laurencebarker/Log-VSWR-Bridge/displays/arduino_library_update/readme.md

These 5 files should be coplied to the ITEADLIB_Arduino_Nextion folder in your "documents\arduino" folder. They replace 4 files in the Arduino library.
