laurencebarker/Log-VSWR-Bridge/displays/crossed needle 20.png

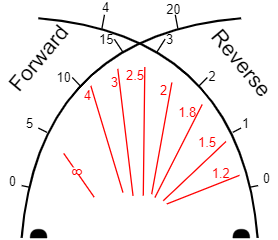
displays/crossed needle 20.png
