laurencebarker/Log-VSWR-Bridge/displays/linear power meter-Analogue Meter 2.png

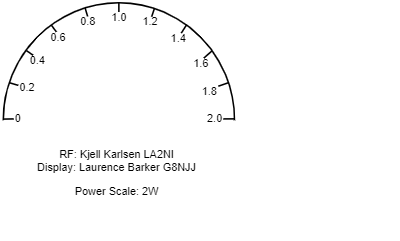
displays/linear power meter-Analogue Meter 2.png
