laurencebarker/Log-VSWR-Bridge/displays/simple bargraph.png

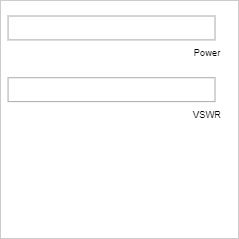
displays/simple bargraph.png
