laurencebarker/Log-VSWR-Bridge/hardware/VSWR bridge BOM.xlsx

VSWR Bridge
Qty | Ref | Part | RS part no.
8 | R1-R4, R9-R12 | 300R size?
4 | R5-R8 | 75R size?
4 | R13, R16, R18, R19 | 560R size?
4 | R14, R17,R31, R32 | 120R
2 | R15, R20 | 27R 0603
2 | R23, R24 | 4R7 0603
2 | R21, R22 | 47K 0603
2 | R29, R30 | wire
2 | R26, R28 | 10K 0603
2 | R25, R27 | 27K 0603
3 | L1, L2, L4 | ferrite bead L 4.5mm W2.1mm
16 | C1, C2, C3, C4, C6, C8, C13, C15-C18, C19, C20, C21, C22, C23 | 100nF 0805
4 | C9-C12 | 47uF +16v tant L=5mm
2 | C5, C7 | 10nF 0805
2 | IC2, IC3 | AD8310
1 | U1 | LMC660
1 | U2 | 78L05
1 | U3 | 78L08
1 | D1 | S1M
2 | J1, J2 | BNC straight
Arduino / Display
Qty | Ref | Part | RS part no.
4 | L2 L3 L4 L6 | Ferrite bead
1 | D3 | 3.3V zener
1 | D2 | BAS16J
2 | D4, D5 | diode SS34
1 | IC1 | Arduino Nano Every
1 | IC3 | TLV1117-5.0
1 | T1 | NX2301P
1 | T2 | 2N7002KL
1 | U1 | LM393
9 | C10, C11, C12, C13, C16, C17, C18, C21, C24 | 100nF 0805
5 | C6, C7,C8,C9,C20 | 10nF 0805
3 | C19, C22, C26 | 1uF 0805
1 | C23 | 4.7uF
2 | C14, C15 | 22uF
2 | C25, C27 | 10uF 0805
2 | R11, R12 | 10K 0603
2 | R8, R9 | 100K 0603
1 | R10 | 180K 0603
1 | R13 | 22K potentiometer
1 | switch | push
1 | case | Hammond 1455N1201
2 | battery | 18650 Li-ion
DNI | C1, C3, C4, C5
DNI | R1 - R7
DNI | L1, L5
DNI | IC2 IC4
DNI | D1
