laurencebarker/Log-VSWR-Bridge/documentation/sensor calibration and lookup table.xlsx

From calibration:
Offset value | -96 | dBm
Scale value | 0.1253 | dBm/step
coupling coefficient | 50 | dB
Zo | 50 | Ω
sensor power dBm = ADC reading*scale + offset |  |  |  |  |  |  |  |  |  |  |  |  | paste 128 cells from column P into Arduino editor
ADC Value | sensor Power dBm | Power W | RMS line volts | start value
0 | -96 | 2.511886432e-08 | 0.001120688724 | 1 | 0.001120688724 | 0.001136972609 | 0.001153493103 | 0.001170253644 | 0.00118725772 | 0.001204508869 | 0.001222010682 | 0.0012397668 | 0.00112,0.00114,0.00115,0.00117,0.00119,0.0012,0.00122,0.00124,
1 | -95.8747 | 2.585413427e-08 | 0.001136972609 | 9 | 0.001257780919 | 0.001276056788 | 0.00129459821 | 0.001313409043 | 0.001332493202 | 0.001351854659 | 0.001371497443 | 0.001391425641 | 0.00126,0.00128,0.00129,0.00131,0.00133,0.00135,0.00137,0.00139,
2 | -95.7494 | 2.661092678e-08 | 0.001153493103 | 17 | 0.001411643401 | 0.001432154929 | 0.001452964496 | 0.00147407643 | 0.001495495127 | 0.001517225042 | 0.001539270698 | 0.001561636683 | 0.00141,0.00143,0.00145,0.00147,0.0015,0.00152,0.00154,0.00156,
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
