laurencebarker/Log-VSWR-Bridge/hardware/LTB Power Meter_Schema.pdf

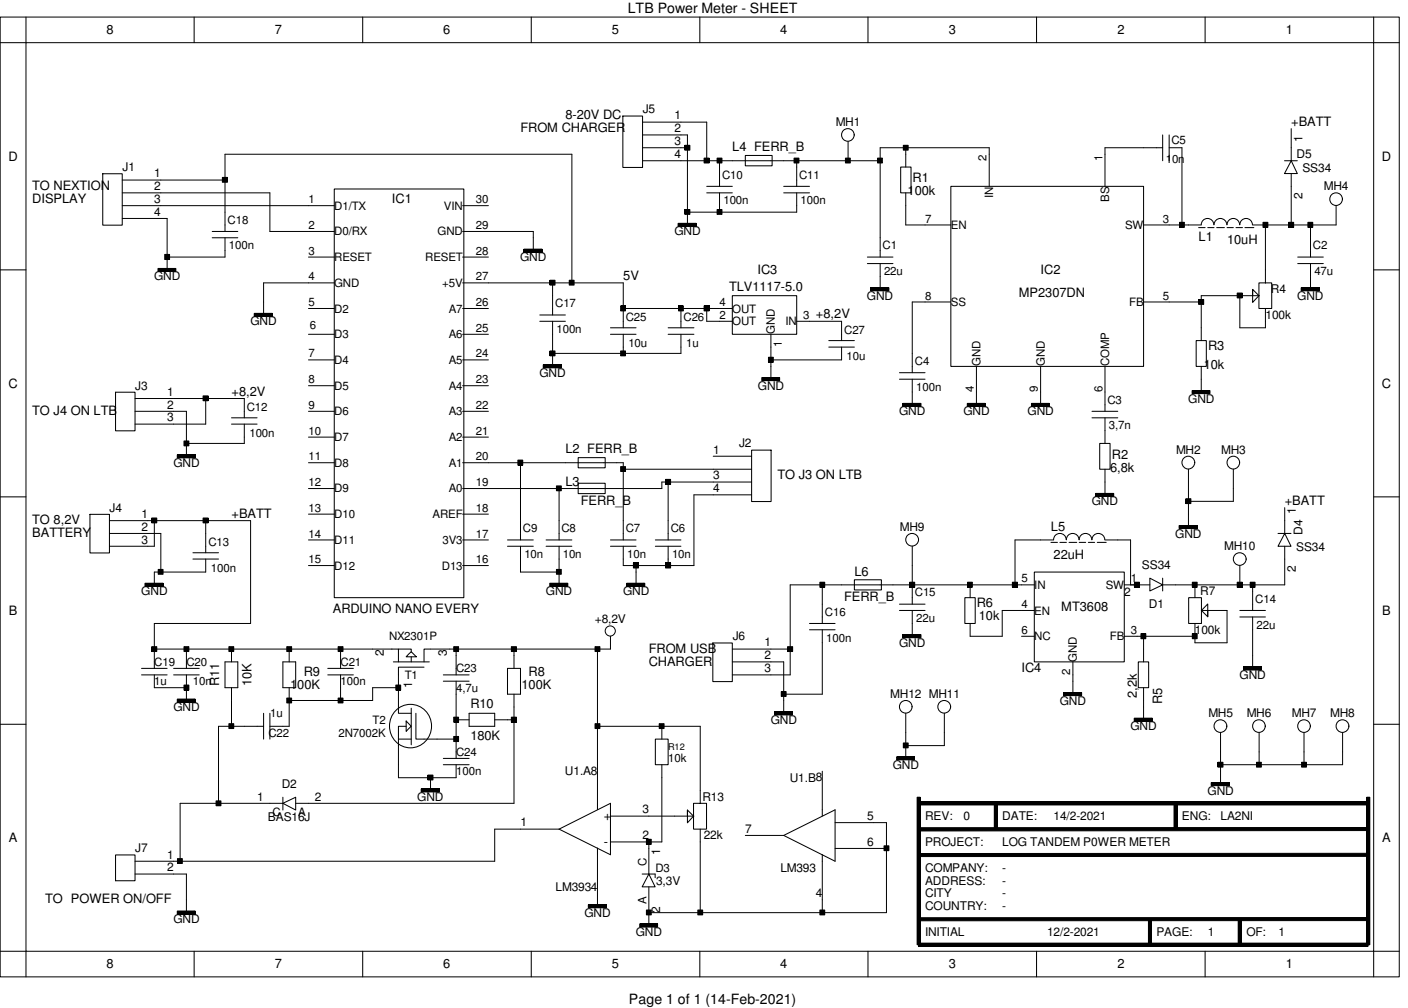
[picture p18: page 1]

LTB Power Meter - SHEET
