laurencebarker/Log-VSWR-Bridge/hardware/LTB Power Meter_Schematic.pdf

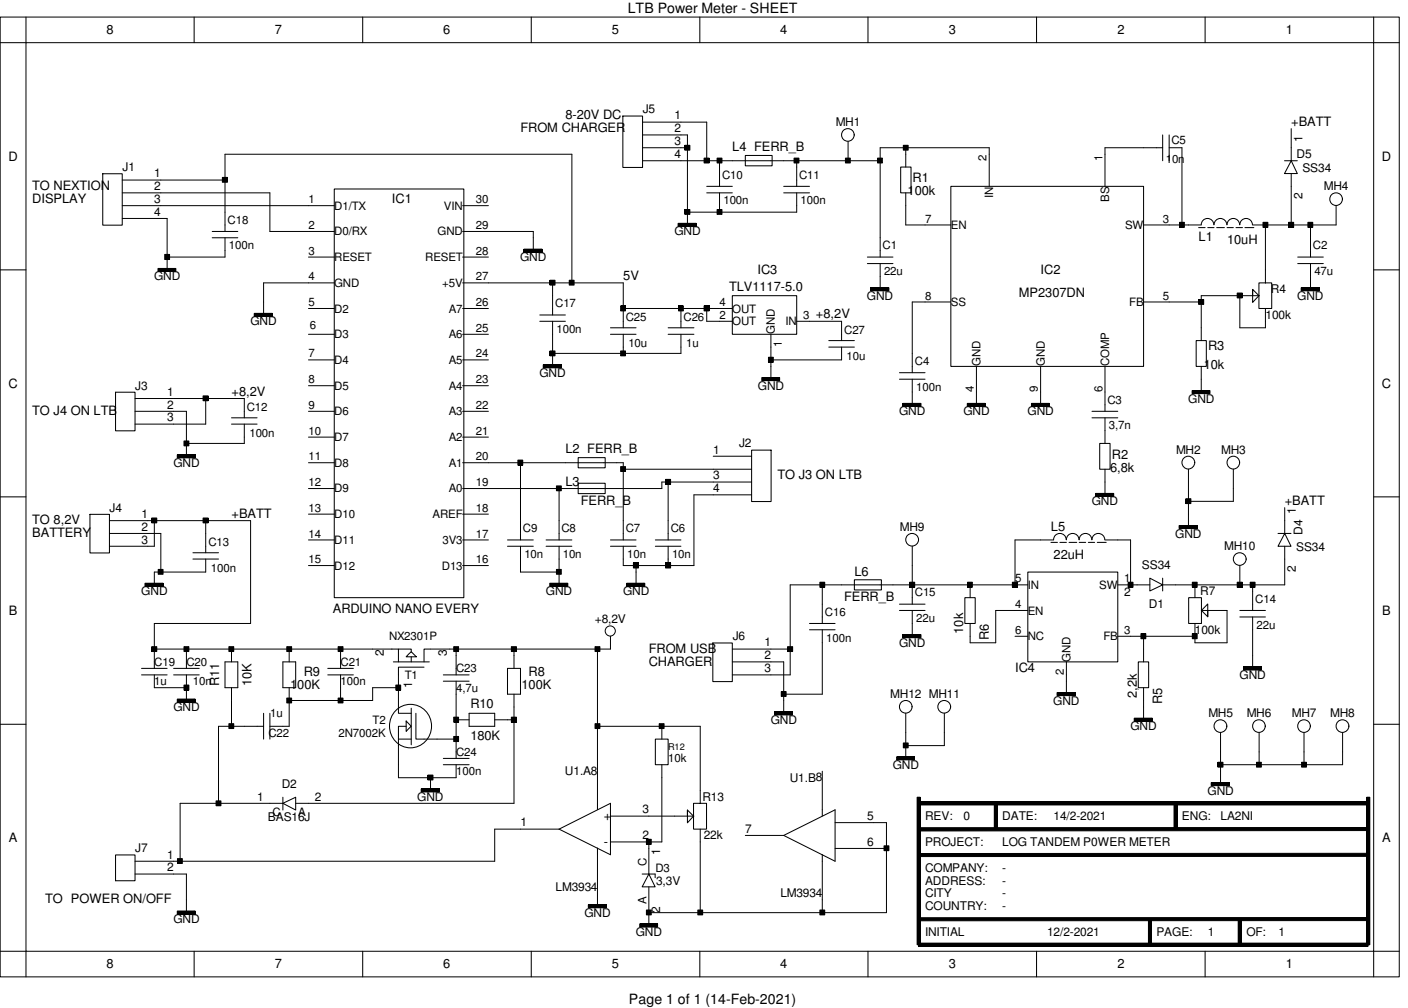
[picture p19: page 1]

LTB Power Meter - SHEET
