laurencebarker/Log-VSWR-Bridge/hardware/LOG TANDEM BRIDGE Rev3.pdf

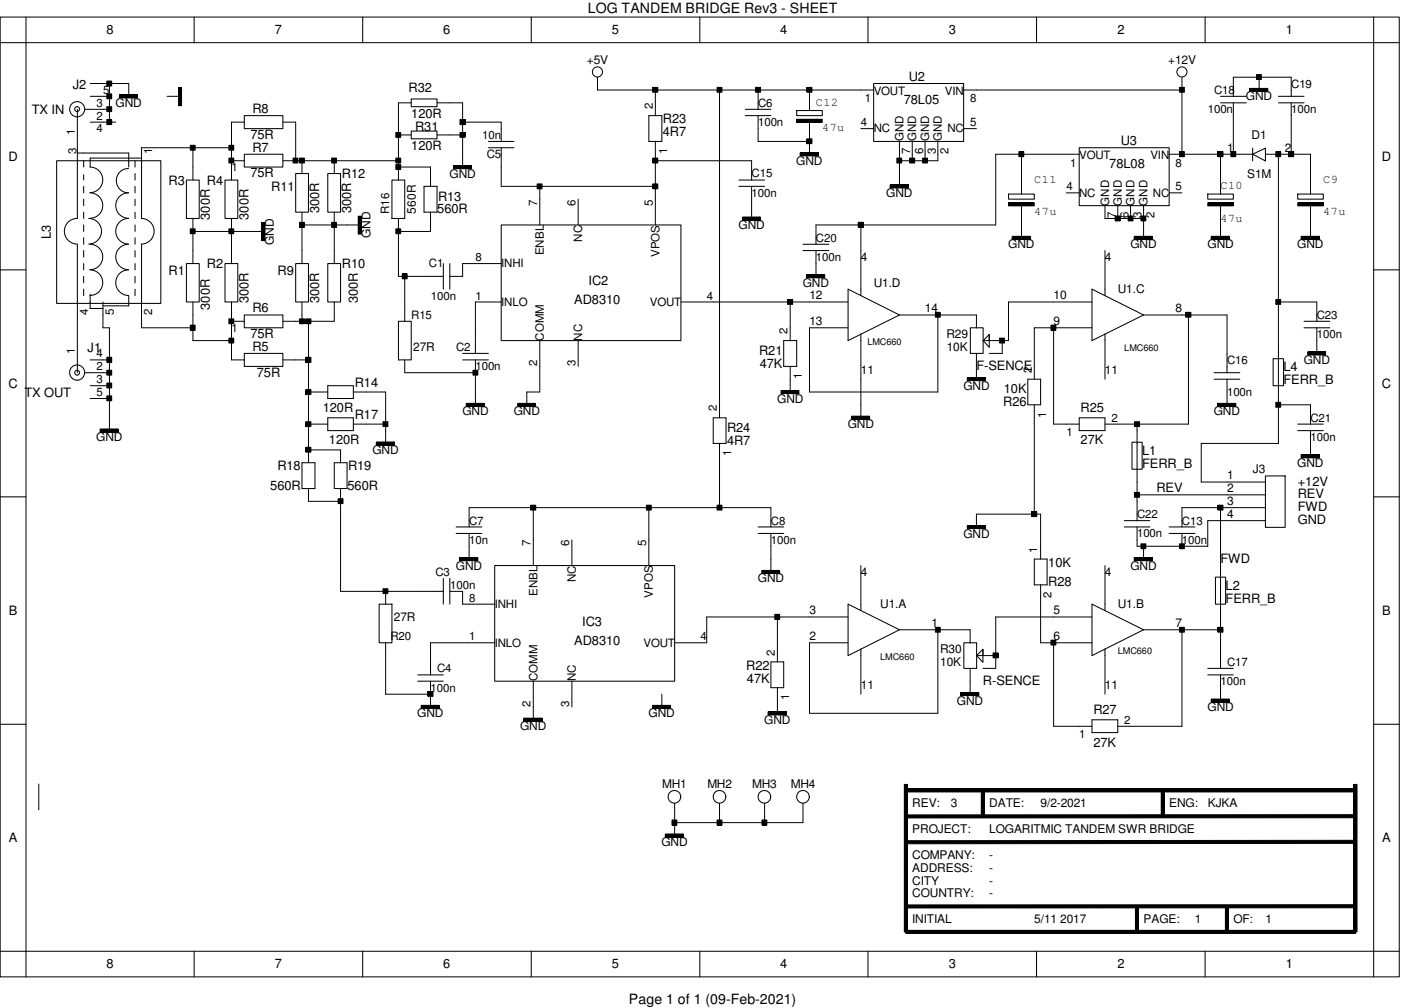
[picture p20: page 1]

LOG TANDEM BRIDGE Rev3 - SHEET

LOGARITMIC TANDEM SWR BRIDGE
