laurencebarker/Log-VSWR-Bridge/hardware/LOG TANDEM BRIDGE Rev3_5-02-21.pdf

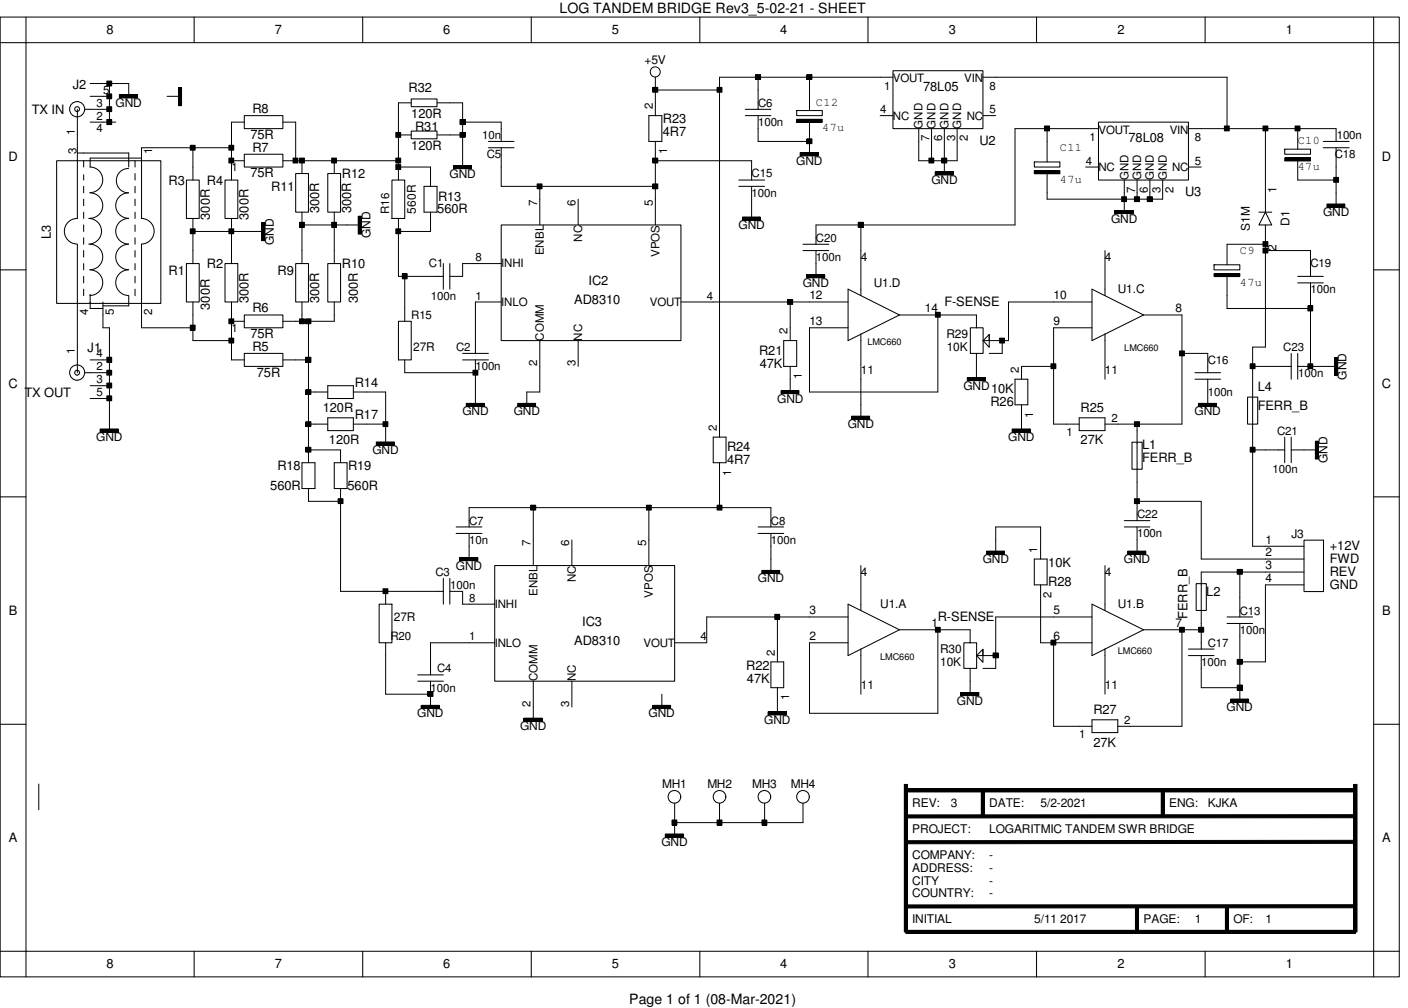
[picture p21: page 1]

LOG TANDEM BRIDGE Rev3_5-02-21 - SHEET

LOGARITMIC TANDEM SWR BRIDGE
