laurencebarker/Log-VSWR-Bridge/hardware/LOG TANDEM BRIDGE Rev3_Schema.pdf

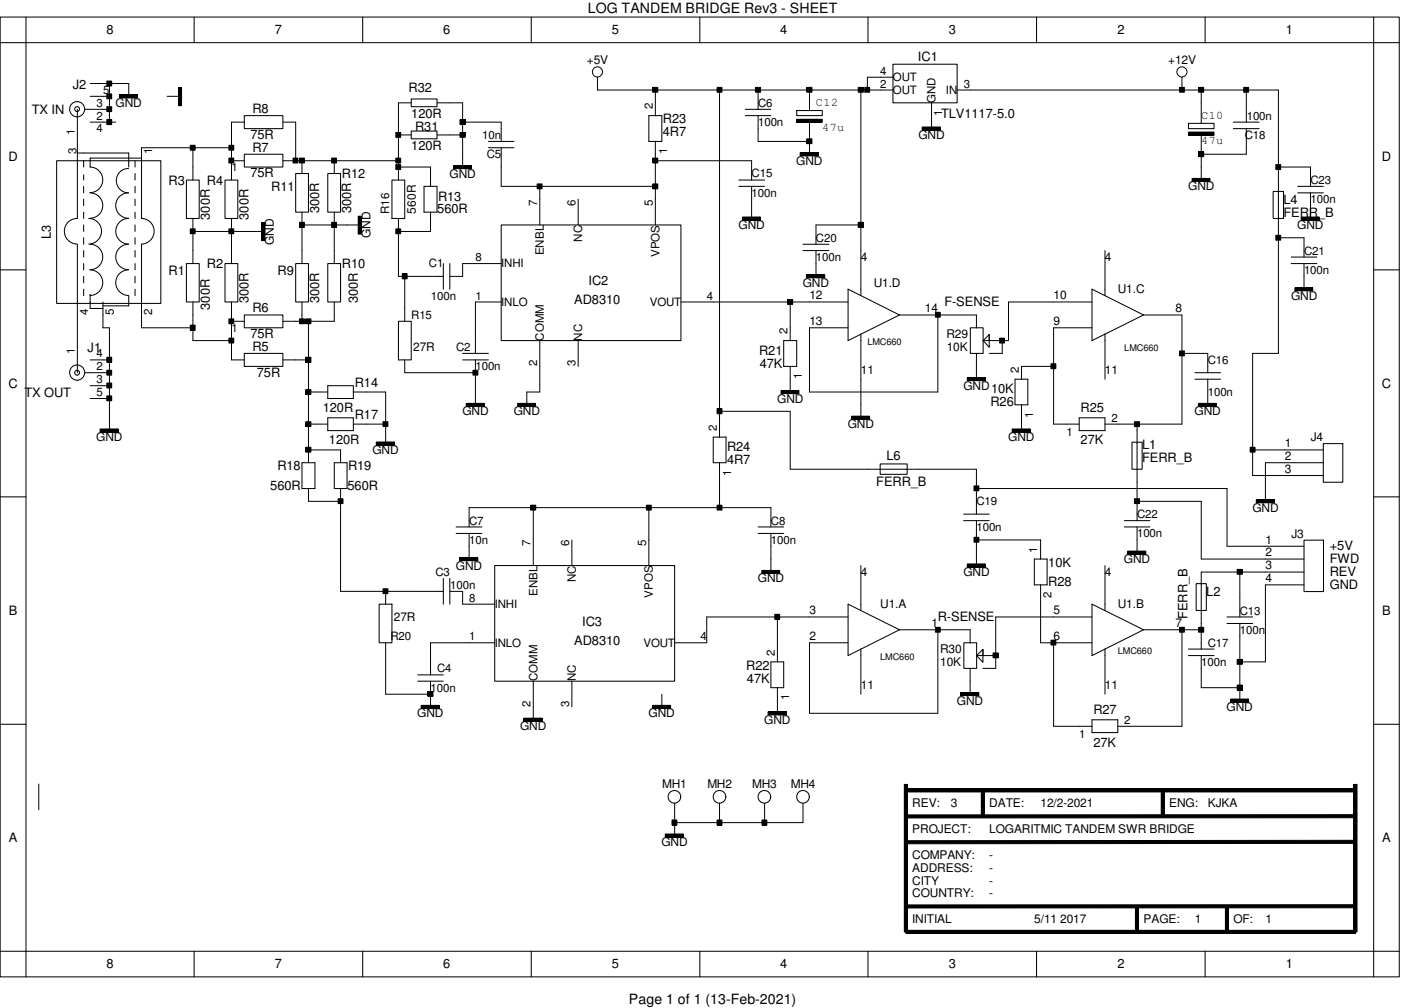
[picture p22: page 1]

LOG TANDEM BRIDGE Rev3 - SHEET

LOGARITMIC TANDEM SWR BRIDGE
