laurencebarker/Log-VSWR-Bridge/hardware/LTB Power Meter_Not_Bottom.pdf

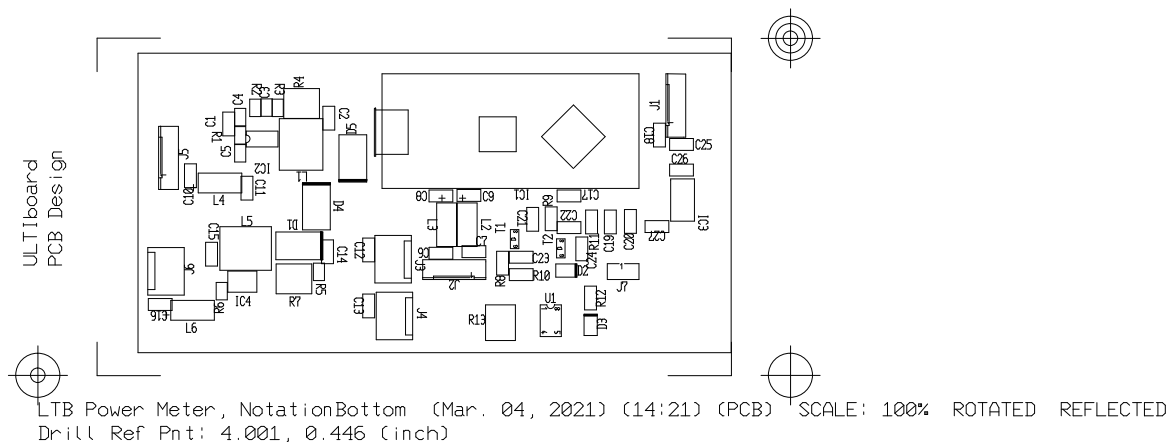
[picture p23: page 1]
