laurencebarker/Log-VSWR-Bridge/hardware/LOG TANDEM BRIDGE 13_11_2020.pdf

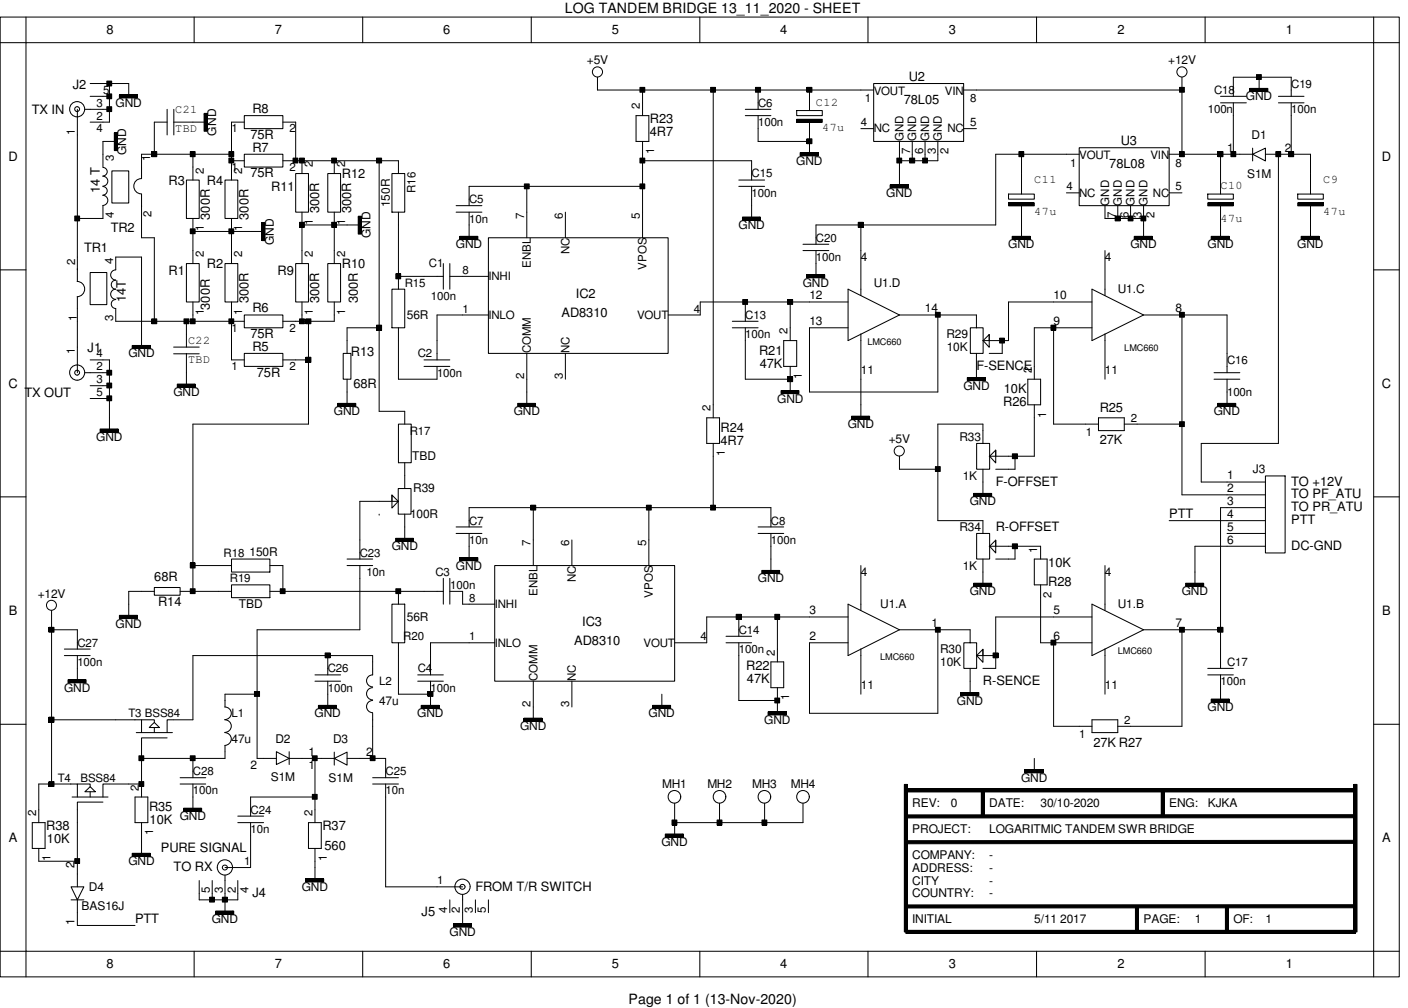
[picture p24: page 1]

LOG TANDEM BRIDGE 13_11_2020 - SHEET

LOGARITMIC TANDEM SWR BRIDGE
