laurencebarker/Log-VSWR-Bridge/LOG TANDEM BRIDGE Rev3_5-02-21.pdf

LOG TANDEM BRIDGE Rev3_5-02-21 - SHEET

LOGARITMIC TANDEM SWR BRIDGE
