laurencebarker/Log-VSWR-Bridge/sketch/Log_VSWR_sketch/analogueio.cpp

/////////////////////////////////////////////////////////////////////////
//
// Log VSWR Bridge Display sketch by Laurence Barker G8NJJ
// copyright (c) Laurence Barker G8NJJ 2020
//
// this sketch provides a VSWR bridge display
//
// the code is written for an Arduino Nano Every module
//
// analogueio.cpp
// this file holds the code to read the analogue inputs
/////////////////////////////////////////////////////////////////////////


#include <Arduino.h>
#include "iopins.h"
#include "analogueio.h"

// scale and offset to get of units of dBm
#define VPOWERDBMOFFSET -96.0
#define VPOWERDBMSCALE 0.1253
#define VCOUPLINGCOEFFICIENT 50.0           // couple loss in dB
#define VZo 50.0
#define VHIGHVSWR 9999                      // 999.9
//
// now a big lookup table from ADC reading to coax line voltage
//
const float GLineVoltageTable[] = 
{
  0.00112,0.00114,0.00115,0.00117,0.00119,0.0012,0.00122,0.00124,
  0.00126,0.00128,0.00129,0.00131,0.00133,0.00135,0.00137,0.00139,
  0.00141,0.00143,0.00145,0.00147,0.0015,0.00152,0.00154,0.00156,
  0.00158,0.00161,0.00163,0.00165,0.00168,0.0017,0.00173,0.00175,
  0.00178,0.0018,0.00183,0.00186,0.00188,0.00191,0.00194,0.00197,
  0.002,0.00202,0.00205,0.00208,0.00211,0.00214,0.00218,0.00221,
  0.00224,0.00227,0.00231,0.00234,0.00237,0.00241,0.00244,0.00248,
  0.00251,0.00255,0.00259,0.00262,0.00266,0.0027,0.00274,0.00278,
  0.00282,0.00286,0.0029,0.00295,0.00299,0.00303,0.00308,0.00312,
  0.00317,0.00321,0.00326,0.00331,0.00335,0.0034,0.00345,0.0035,
  0.00355,0.00361,0.00366,0.00371,0.00376,0.00382,0.00388,0.00393,
  0.00399,0.00405,0.00411,0.00416,0.00423,0.00429,0.00435,0.00441,
  0.00448,0.00454,0.00461,0.00467,0.00474,0.00481,0.00488,0.00495,
  0.00502,0.0051,0.00517,0.00525,0.00532,0.0054,0.00548,0.00556,
  0.00564,0.00572,0.0058,0.00589,0.00597,0.00606,0.00615,0.00624,
  0.00633,0.00642,0.00651,0.00661,0.0067,0.0068,0.0069,0.007,
  0.0071,0.00721,0.00731,0.00742,0.00752,0.00763,0.00774,0.00786,
  0.00797,0.00809,0.0082,0.00832,0.00844,0.00857,0.00869,0.00882,
  0.00895,0.00908,0.00921,0.00934,0.00948,0.00962,0.00976,0.0099,
  0.01004,0.01019,0.01033,0.01048,0.01064,0.01079,0.01095,0.01111,
  0.01127,0.01143,0.0116,0.01177,0.01194,0.01211,0.01229,0.01247,
  0.01265,0.01283,0.01302,0.01321,0.0134,0.01359,0.01379,0.01399,
  0.01419,0.0144,0.01461,0.01482,0.01504,0.01526,0.01548,0.0157,
  0.01593,0.01616,0.0164,0.01664,0.01688,0.01712,0.01737,0.01762,
  0.01788,0.01814,0.0184,0.01867,0.01894,0.01922,0.0195,0.01978,
  0.02007,0.02036,0.02065,0.02095,0.02126,0.02157,0.02188,0.0222,
  0.02252,0.02285,0.02318,0.02352,0.02386,0.02421,0.02456,0.02491,
  0.02528,0.02564,0.02602,0.02639,0.02678,0.02717,0.02756,0.02796,
  0.02837,0.02878,0.0292,0.02962,0.03005,0.03049,0.03093,0.03138,
  0.03184,0.0323,0.03277,0.03325,0.03373,0.03422,0.03472,0.03522,
  0.03573,0.03625,0.03678,0.03731,0.03786,0.03841,0.03897,0.03953,
  0.04011,0.04069,0.04128,0.04188,0.04249,0.04311,0.04373,0.04437,
  0.04501,0.04567,0.04633,0.047,0.04769,0.04838,0.04908,0.04979,
  0.05052,0.05125,0.052,0.05275,0.05352,0.0543,0.05509,0.05589,
  0.0567,0.05752,0.05836,0.05921,0.06007,0.06094,0.06182,0.06272,
  0.06363,0.06456,0.0655,0.06645,0.06741,0.06839,0.06939,0.07039,
  0.07142,0.07246,0.07351,0.07458,0.07566,0.07676,0.07787,0.07901,
  0.08015,0.08132,0.0825,0.0837,0.08492,0.08615,0.0874,0.08867,
  0.08996,0.09127,0.09259,0.09394,0.0953,0.09669,0.09809,0.09952,
  0.10096,0.10243,0.10392,0.10543,0.10696,0.10852,0.11009,0.11169,
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
};



//
// global variables
//
int GFwdPeakADC, GRevPeakADC;                       // forward, reverse peak ADC readings, no scaling
unsigned int  GFwdSumADC, GRevSumADC;               // summed readings for each ADC for averaging
byte GFwdCount, GRevCount;                          // number of summed readings              
bool GIsFwd;                                        // most recent readin was forward ADC
//
// sensor values, as 1DP fixed point integers
//
int GForwardTenthdBm;
int GReverseTenthdBm;
unsigned int GFwdLineVoltageTenth;
unsigned int GRevLineVoltageTenth;
unsigned int GFwdAvgPowerTenth;
unsigned int GRevAvgPowerTenth;
unsigned int GFwdPeakPowerTenth;
unsigned int GRevPeakPowerTenth;
unsigned int GVSWR;                               // set to 9999 if impossible


//
// buffer of forward and reverse power values for peak finding
// a new value written every tick; search all buffer for peak over last N entries
//
#define VSIZEPEAKBUFFER 32
unsigned int GForwardPowerBuffer[VSIZEPEAKBUFFER];          // circular buffer (units tenth of a watt)
unsigned int GReversePowerBuffer[VSIZEPEAKBUFFER];          // circular buffer (units tenth of a watt)
byte GPeakPointer;                                          // pointer into circular buffer

//
// buffer of forward and reverse power values for averaging
// a new value written every tick; average over last N entries
//
#define VSIZEAVGBUFFER 32
unsigned int GForwardAvgPowerBuffer[VSIZEAVGBUFFER];          // circular buffer (units tenth of a watt)
unsigned int GReverseAvgPowerBuffer[VSIZEAVGBUFFER];          // circular buffer (units tenth of a watt)
byte GAvgPointer;                                          // pointer into circular buffer


//
// AnalogueIO initialise
//
void AnalogueIOInit(void)
{
}



//
// fast tick: read one ADC value and store peak value found
//
void AnalogueIOFastTick()
{
  int Reading;
  if(GIsFwd)
  {
    Reading = analogRead(VPINREVPOWERADC);                      // get ADC reading for reverse RF power
    if(Reading > GRevPeakADC)
      GRevPeakADC = Reading;
    GRevSumADC += Reading;                                      // sum the ADC readings so we can average them
    GRevCount++;
  }
  else
  {
    Reading = analogRead(VPINFWDPOWERADC);                      // get ADC reading for forward RF power
    if(Reading > GFwdPeakADC)
      GFwdPeakADC = Reading;
    GFwdSumADC += Reading;                                      // sum the ADC readings so we can average them
    GFwdCount++;
  }
  GIsFwd = !GIsFwd;                                     // other ADC next tick
}


//
// AnalogueIO tick
// read the ADC values then convert to units of dBm
// (timed at ~1ms)
//
void AnalogueIOTick(void)
{
  int SensorReading;
  unsigned int SummedReading;
  byte SummedCount;
  float ScaledReading;
  float FwdVoltage, RevVoltage;
  float Power;

  if(++GPeakPointer >= VSIZEPEAKBUFFER)                             // advance the peak buffer location
    GPeakPointer = 0;
  if(++GAvgPointer >= VSIZEAVGBUFFER)                               // advance the average buffer location
    GAvgPointer = 0;


//
// calculate forward powers
//
  SensorReading = GFwdPeakADC;                                      // get ADC reading for forward RF power
  GFwdPeakADC = 0;
  SummedReading = GFwdSumADC;
  GFwdSumADC = 0;
  SummedCount = GFwdCount;
  GFwdCount = 0;

// find averaged log power reading and store
  SummedReading = SummedReading / SummedCount;                      // averaged ADC reading over the last N samples
  ScaledReading = (float)SummedReading;                             // float avg
  ScaledReading = VPOWERDBMOFFSET + ScaledReading * VPOWERDBMSCALE + VCOUPLINGCOEFFICIENT; // dBm value of line power
  GForwardTenthdBm = (int)(ScaledReading*10.0);

// find average power in W
  FwdVoltage = GLineVoltageTable[SummedReading];
  GFwdLineVoltageTenth = (int)(FwdVoltage * 10.0);
  Power = 10.0 * FwdVoltage * FwdVoltage / VZo;                     // units of 0.1W
  if (Power > 60000)                                                // clip if too big for an unsigned int
    GFwdAvgPowerTenth = 60000;
  else
    GFwdAvgPowerTenth = (int)Power;
  GForwardAvgPowerBuffer[GAvgPointer] = GFwdAvgPowerTenth;

// now find peak power in W  and write to the buffer
  FwdVoltage = GLineVoltageTable[SensorReading];
  GFwdLineVoltageTenth = (int)(FwdVoltage * 10.0);
  Power = 10.0 * FwdVoltage * FwdVoltage / VZo;                     // units of 0.1W
  if (Power > 60000)                                                // clip if too big for an unsigned int
    GFwdPeakPowerTenth = 60000;
  else
    GFwdPeakPowerTenth = (int)Power;
  GForwardPowerBuffer[GPeakPointer] = GFwdPeakPowerTenth;

//
// now calculate the same for reverse powers
//
  SensorReading = GRevPeakADC;                                      // get ADC reading for reverse RF power
  GRevPeakADC = 0;
  SummedReading = GRevSumADC;
  GRevSumADC = 0;
  SummedCount = GRevCount;
  GRevCount = 0;

// find averaged log power reading and store
  SummedReading = SummedReading / SummedCount;                      // averaged ADC reading over the last N samples
  ScaledReading = (float)SummedReading;                             // float avg
  ScaledReading = VPOWERDBMOFFSET + ScaledReading * VPOWERDBMSCALE + VCOUPLINGCOEFFICIENT; // dBm value of line power
  GReverseTenthdBm = (int)(ScaledReading*10.0);

// find average power in W
  RevVoltage = GLineVoltageTable[SummedReading];
  GRevLineVoltageTenth = (int)(RevVoltage * 10.0);
  Power = 10.0 * RevVoltage * RevVoltage / VZo;                     // units of 0.1W
  if (Power > 60000)                                                // clip if too big for an unsigned int
    GRevAvgPowerTenth = 60000;
  else
    GRevAvgPowerTenth = (int)Power;
  GReverseAvgPowerBuffer[GAvgPointer] = GRevAvgPowerTenth;

// now find peak power in W  and write to the buffer
  RevVoltage = GLineVoltageTable[SensorReading];
  GRevLineVoltageTenth = (int)(RevVoltage * 10.0);
  Power = 10.0 * RevVoltage * RevVoltage / VZo;                     // units of 0.1W
  if (Power > 60000)                                                // clip if too big for an unsigned int
    GRevPeakPowerTenth = 60000;
  else
    GRevPeakPowerTenth = (int)Power;
  GReversePowerBuffer[GPeakPointer] = GRevPeakPowerTenth;


//
// finally VSWR
// for low sensor readings, set VSWR=1
//
  if(FwdVoltage < 0.1)
    GVSWR = 10.0;                                 // 10x value
  else if(FwdVoltage == RevVoltage)
    GVSWR = VHIGHVSWR;
  else
    GVSWR = abs(10.0 * (FwdVoltage + RevVoltage) / (FwdVoltage - RevVoltage));
}


//
// find peak power by searching buffer
// returns a power peak value
// 1st parameter true for forward power
// 2nd paramter true for units of tenths of a watt
//
unsigned int FindPeakPower(bool IsFwdPower, bool InTenths)
{
  unsigned int* Ptr;                                                  // buffer pointer
  byte Cntr;
  unsigned int Result = 0;
  
  if(IsFwdPower)
    Ptr = GForwardPowerBuffer;
  else
    Ptr = GReversePowerBuffer;
  for (Cntr = 0; Cntr < VSIZEPEAKBUFFER; Cntr++)
  {
    if(*Ptr > Result)
      Result = *Ptr;
    Ptr++;
  }
  if(!InTenths)                                                      // convert to watts if needed
    Result = Result/10;
  
  return Result;
}



//
// returns an average power value
// 1st parameter true for forward power
// 2nd parameter true for units of tenths of a watt
//
unsigned int GetPowerReading(bool IsFwdPower, bool InTenths)
{
  unsigned int* Ptr;                                                  // buffer pointer
  byte Cntr;
  unsigned long Sum = 0;
  unsigned int Result;
  
  if(IsFwdPower)
    Ptr = GForwardAvgPowerBuffer;
  else
    Ptr = GReverseAvgPowerBuffer;

  for (Cntr = 0; Cntr < VSIZEAVGBUFFER; Cntr++)
    Sum += *Ptr++;

  Result = (unsigned int)(Sum / VSIZEAVGBUFFER);
  if(!InTenths)                                                      // convert to watts if needed
    Result = Result/10;
  
  return Result;
}
