laurencebarker/Log-VSWR-Bridge/(commit log)

2020-12-24 1st design release with 5 displays. Documentation updated.
    [x-needle display tick position calculator.xlsx]
2021-04-04 fixed display operation with USB disconnected
    When USB disconnected on an Arduino Nano Every, the nexInit() doesn't complete properly. After every command the recRecCommandFinished() driver function waits for a display response until the 100ms timeout is reached.
    Resend sendCommand("bkcmd=1"); when exiting the splash page to fix.
    [VSWR bridge BOM.xlsx, sensor calibration and lookup table.xlsx]
